SignalPocket/archive-module-3030/README.md

# ARCHIVE MODULE 3030 — production candidate

This version uses the tested dimensions and replaces the unreliable flex latch with a magnetic drawer detent.

> Private personal project. Please do not publish, share, fork, or redistribute the proposal text or artwork.

## Repository contents

- `print-files/` — six separate plate-ready 3MF jobs; start here for Bambu Studio.
- `models/` — editable OpenSCAD source, assembled reference 3MF, and individual printable STL parts.
- `docs/TRANSMISSION.txt` — final proposal transmission copy.
- `docs/assembly-diagram.html` — interactive exploded, closed, and open assembly sketches.
- `docs/lego-style-assembly-guide.svg` — numbered four-step hardware and layer assembly guide.
- `renders/final-assembly-diagram.png` — accurate closed/reveal comparison rendered directly from the approved SCAD geometry.
- `renders/assembly_preview.png` — assembled color preview.
- `history/` — the complete sequence of calibration parts, prototypes, discarded mechanisms, early models, build scripts, renders, and original ZIP packages.
- [`EVOLUTION.md`](EVOLUTION.md) — what changed at each stage and what the physical tests taught us.

## Visual construction

- Black PLA chassis and top lid.
- Iron-gray PLA drawer and armor plate.
- Yellow PETG timeline overlay, secured by four exposed M2 × 8 mm event screws.
- Two hidden black retaining clips capture the rear edge of the lid and armor.
- Parameterized black PLA lettering printed directly into/on the iron-gray armor as an AMS multicolor part.
- Each screw marks a completed archival event: 05.14.2023, 05.28.2023, 10.12.2023, and 08.29.2026.
- The open yellow ring nearest the drawer represents 09.26.2026: a record awaiting its response.
- Red PLA reveal plate inside the drawer.

## Calibrated dimensions

- Drawer clearance: 0.15 mm per side, derived from the successful 0.10 mm short-rail test with 0.05 mm full-length allowance.
- Magnet pockets: 6.10 × 3.20 mm.
- M2 clearance holes: 2.30 mm.
- M2 pilot holes: 1.70 mm.

## Print order

Do not begin with the large chassis.

Use the numbered jobs in `print-files/`. The combined 3MF under `models/` is an assembled reference and is not intended to be sliced as one plate.

1. Print `models/drawer_gray.stl` and verify that the magnet seats in its pocket without force.
2. Print `models/chassis_black.stl`. Before adding adhesive, slide the empty drawer through its full travel.
3. Install the two magnets only after checking their attraction direction. Use a tiny amount of thick CA or two-part epoxy.
4. Print `models/lid_black.stl`, `models/armor_gray.stl`, and `models/timeline_yellow.stl`.
5. For the armor, import `models/armor_gray.stl` and `models/top_text_black.stl` together as one object with multiple parts. Assign iron-gray PLA to the armor and black PLA to the text. The meshes are already aligned; do not auto-arrange them separately.
6. Stack lid → armor → yellow timeline. Angle the stack slightly, tuck its rear edge beneath both black retaining clips, then lower the front edge. Install four M2 × 8 mm screws through the completed-event nodes. Tighten only until seated; PETG can deform if overtightened.
7. Print `models/reveal_red.stl`, check its reading orientation, and install it in the drawer.
8. Add the folded transmission last.

## Editing the top wording

Open `models/archive_module_3030_final.scad` and change `TITLE_TEXT` or `STATUS_TEXT` near the top. Export both `armor` and `top_text` after changing the wording so their registration surfaces continue to match. The circular date dials are controlled by `EVENT_YEARS`, `EVENT_DAYS`, `OPEN_EVENT_YEAR`, and `OPEN_EVENT_DAY`.

## Opening grip

The drawer is opened through the widened concealed window on the underside. Five shallow grooves in the drawer floor provide traction while pulling directly against the magnet pair.

## Suggested settings

- Chassis: Black PLA, flat bottom on the build plate with the open tray facing upward; 0.20 mm, 4 walls, 20% gyroid, no supports expected.
- Drawer: Iron Gray PLA, flat bottom on the plate, 0.20 mm, 4 walls, 20% gyroid, no supports.
- Lid and armor: flat, 0.16–0.20 mm, 4 walls.
- Yellow timeline: Yellow PETG HF, flat, 0.16 mm, 5 walls, 100% infill, no supports.
- Red reveal: Red PLA, flat, 0.16 mm; ironing optional.

## Important

This is the first full-size production candidate. Test the empty drawer before installing magnets, the red reveal, or the transmission. Keep the four top screws snug rather than tight.
