SignalPocket/archive-module-3030/extras/keychain/renders/john_3030_keychain_preview.png

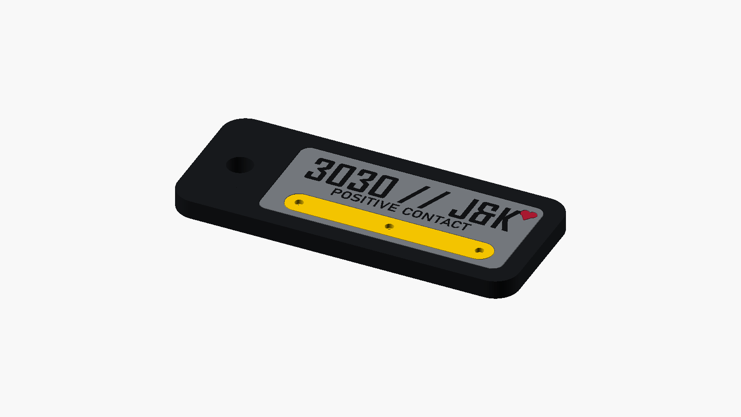
extras/keychain/renders/john_3030_keychain_preview.png
