SignalPocket/archive-module-3030/renders/final_closed.png

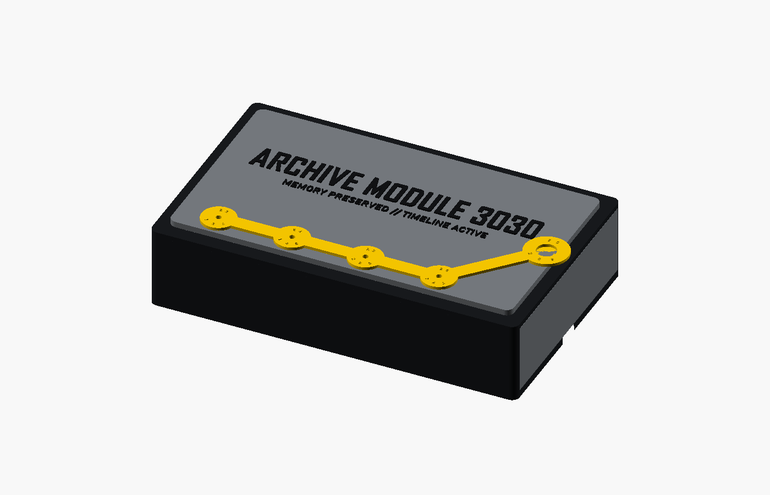
renders/final_closed.png
