SignalPocket/archive-module-3030/renders/final_open.png

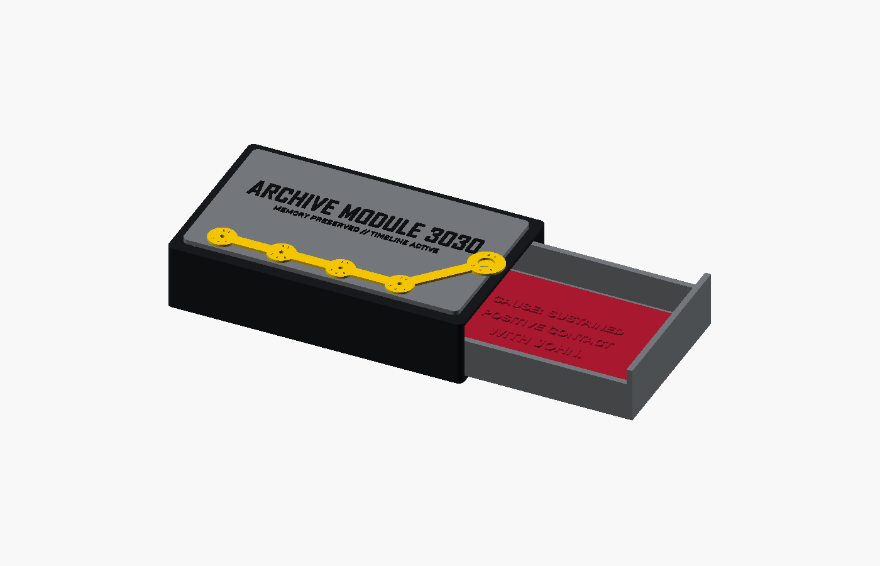
renders/final_open.png
