SignalPocket/archive-module-3030/extras/keychain/models/face_gray.stl

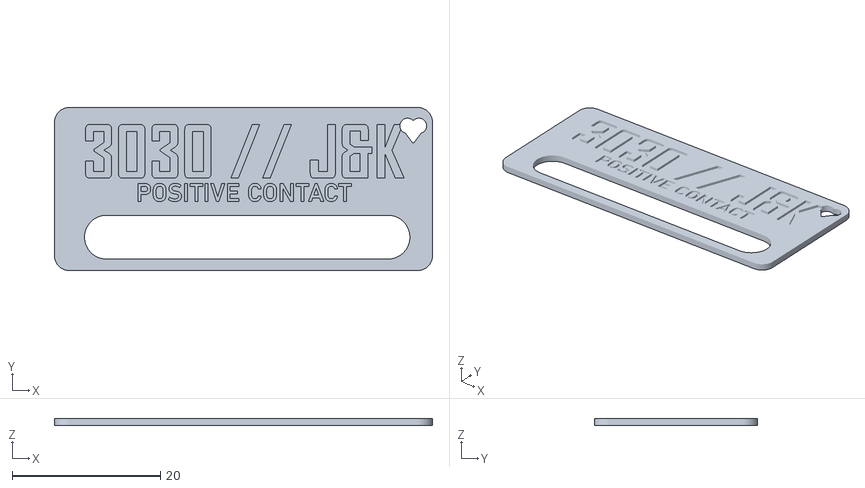
[picture p4: CAD file, 2026-09-24]
extras/keychain/models/face_gray.stl
51.0 x 22.0 x 1.00
