SignalPocket/archive-module-3030/extras/keychain/print-files/01_keychain_black_gray_red_ams.3mf

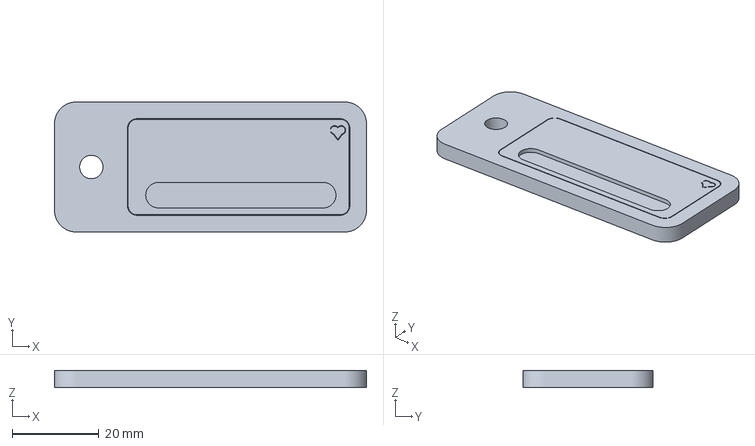
[picture p5: CAD file, 2026-10-22]
extras/keychain/print-files/01_keychain_black_gray_red_ams.3mf
72.0 x 30.0 x 4.00 mm
