SignalPocket/archive-module-3030/history/01-printer-calibration/storage_case_slider.stl

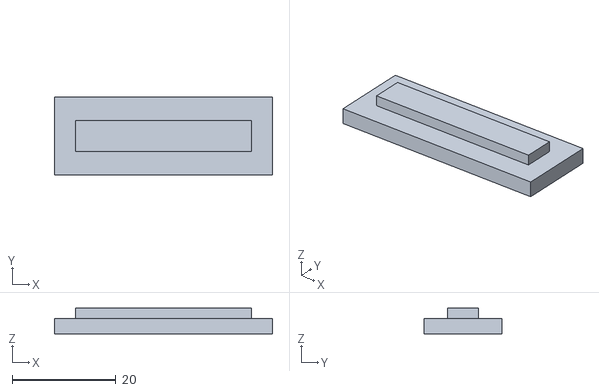
[picture p6: CAD file, 2026-09-23]
history/01-printer-calibration/storage_case_slider.stl
42.0 x 15.0 x 5.00
