SignalPocket/archive-module-3030/history/02-printer-calibration-v2/magnet_sleeve_610.stl

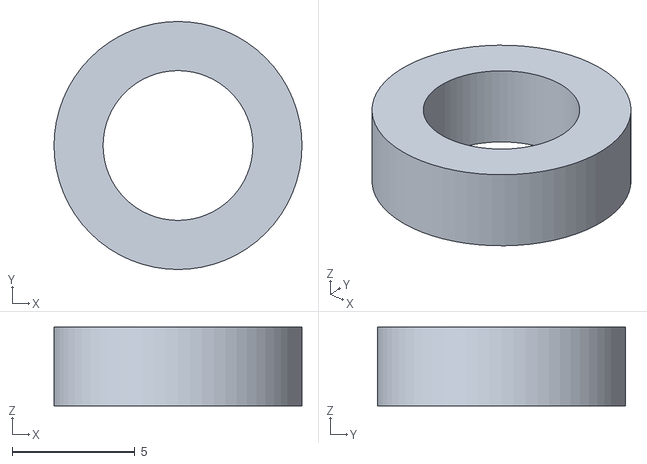
[picture p7: CAD file, 2026-09-23]
history/02-printer-calibration-v2/magnet_sleeve_610.stl
10.1 x 10.1 x 3.20
