SignalPocket/archive-module-3030/history/03-printer-calibration-v3/rail_clearance_020.stl

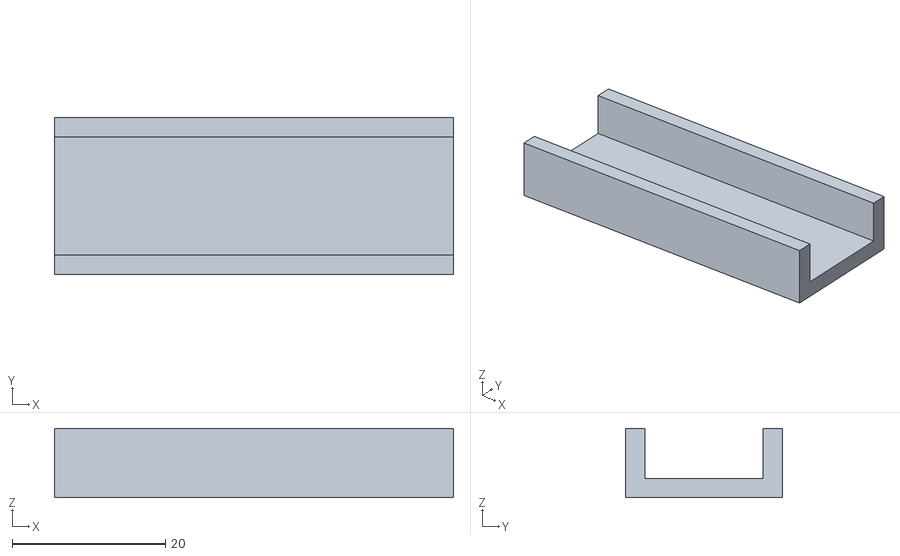
[picture p8: CAD file, 2026-09-23]
history/03-printer-calibration-v3/rail_clearance_020.stl
52.0 x 20.4 x 9.00
