SignalPocket/archive-module-3030/history/04-petg-flexure/flexure_180.stl

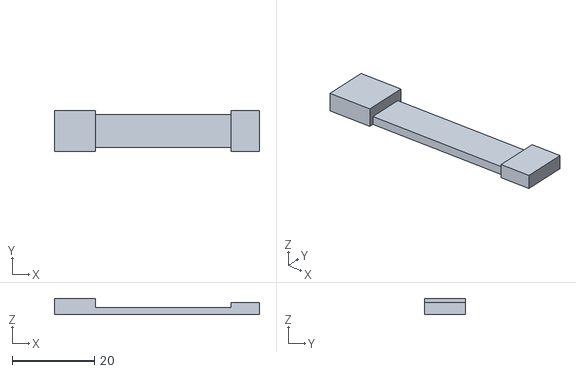
[picture p9: CAD file, 2026-09-23]
history/04-petg-flexure/flexure_180.stl
50.0 x 10.0 x 4.00
