SignalPocket/archive-module-3030/history/05-latch-catch-test/catch_slider_gray.stl

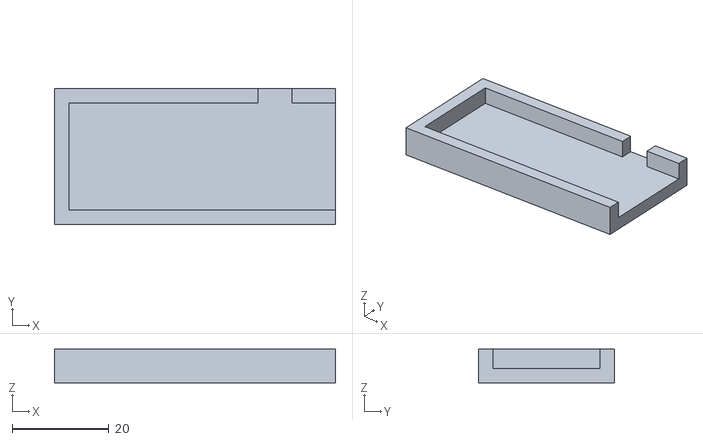
[picture p10: CAD file, 2026-09-23]
history/05-latch-catch-test/catch_slider_gray.stl
58.0 x 28.0 x 7.00
