SignalPocket/archive-module-3030/history/06-first-full-concept/reveal_plate_red.stl

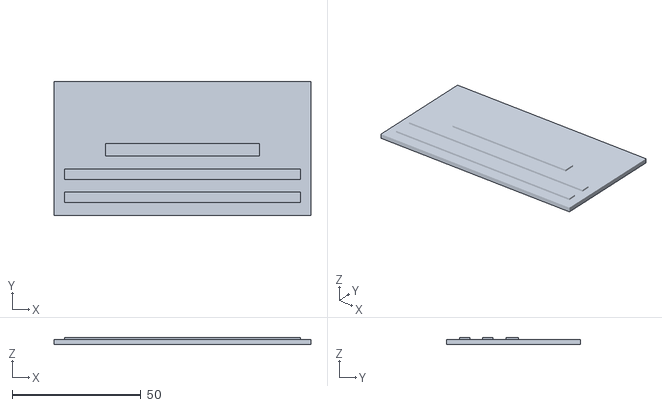
[picture p11: CAD file, 2026-09-23]
history/06-first-full-concept/reveal_plate_red.stl
100.0 x 52.0 x 2.80
