SignalPocket/archive-module-3030/history/08-approved-model-v2/models/reveal_red.stl

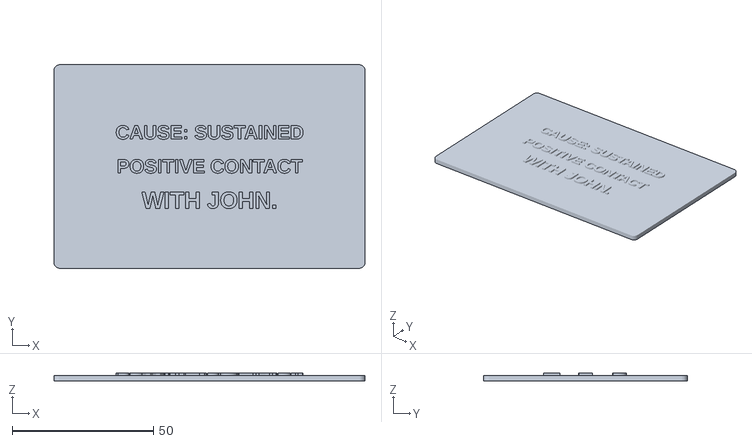
[picture p12: CAD file, 2026-09-23]
history/08-approved-model-v2/models/reveal_red.stl
110.0 x 72.0 x 2.80
