SignalPocket/archive-module-3030/models/drawer_gray.3mf

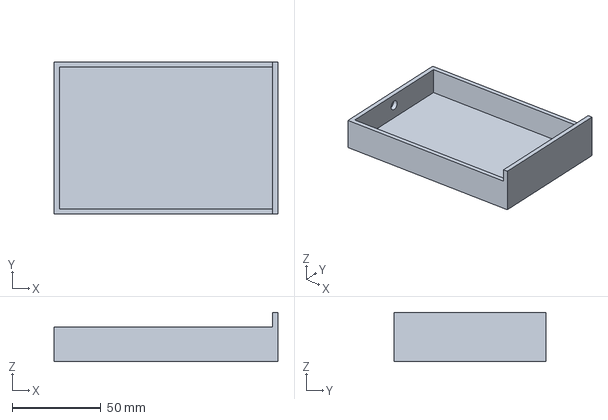
[picture p13: CAD file, 2026-10-22]
models/drawer_gray.3mf
126.0 x 85.7 x 27.7 mm
