SignalPocket/archive-module-3030/print-files/04_armor_gray_black_ams.3mf

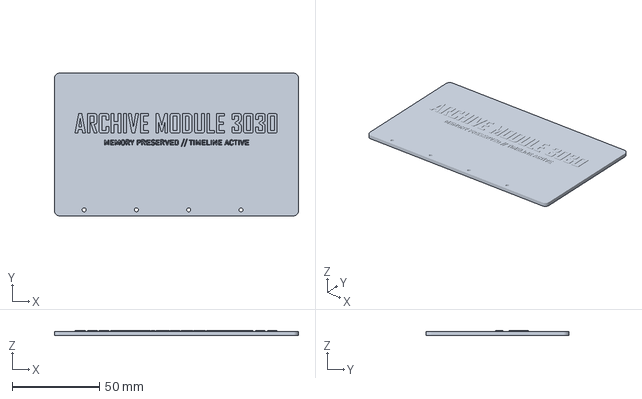
[picture p14: CAD file, 2026-10-22]
print-files/04_armor_gray_black_ams.3mf
140.0 x 82.0 x 3.00 mm
