SignalPocket/archive-module-3030/extras/keychain/models/text_black.stl

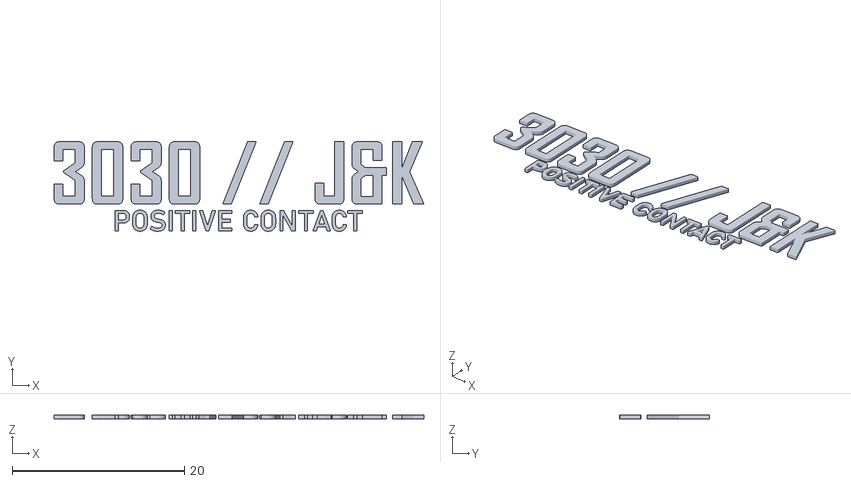
[picture p15: CAD file, 2026-09-24]
extras/keychain/models/text_black.stl
43.0 x 10.4 x 0.42
