SignalPocket/archive-module-3030/extras/keychain/print-files/02_signal_yellow_petg.3mf

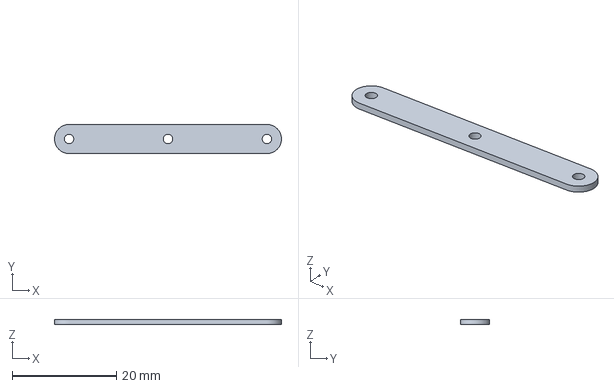
[picture p16: CAD file, 2026-10-22]
extras/keychain/print-files/02_signal_yellow_petg.3mf
43.6 x 5.60 x 1.00 mm
