SignalPocket/archive-module-3030/history/01-printer-calibration/storage_case_rail.3mf

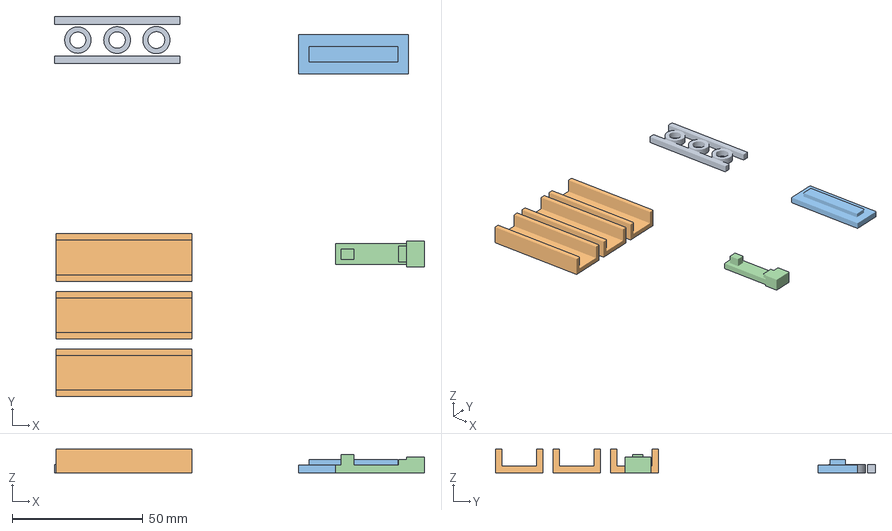
[picture p17: CAD file, 2026-09-23]
history/01-printer-calibration/storage_case_rail.3mf
141.5 x 145.2 x 9.00 mm
magnet_fit_coupon.stl
storage_case_rail.stl
storage_case_slider.stl
cable_clip_flex_test.stl
