SignalPocket/archive-module-3030/history/02-printer-calibration-v2/m2_clearance_230.stl

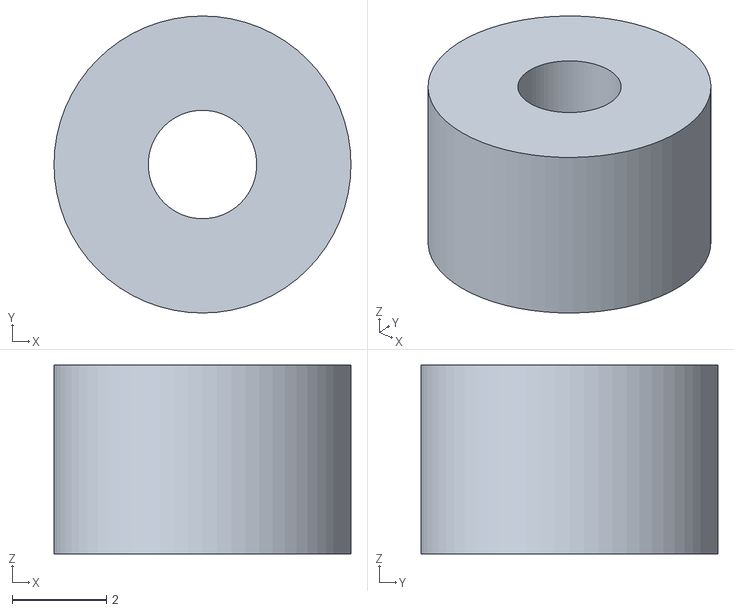
[picture p18: CAD file, 2026-09-23]
history/02-printer-calibration-v2/m2_clearance_230.stl
6.30 x 6.30 x 4.00
