SignalPocket/archive-module-3030/history/04-petg-flexure/flexure_120.stl

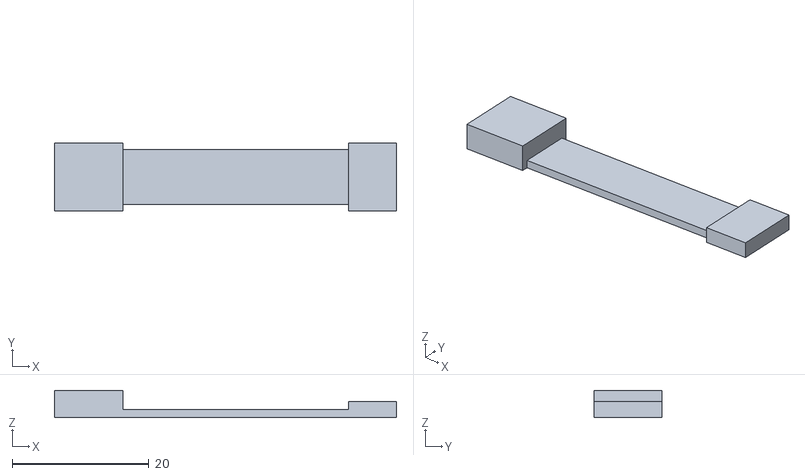
[picture p19: CAD file, 2026-09-23]
history/04-petg-flexure/flexure_120.stl
50.0 x 10.0 x 4.00
