SignalPocket/archive-module-3030/history/05-latch-catch-test/latch_test_jig_black.stl

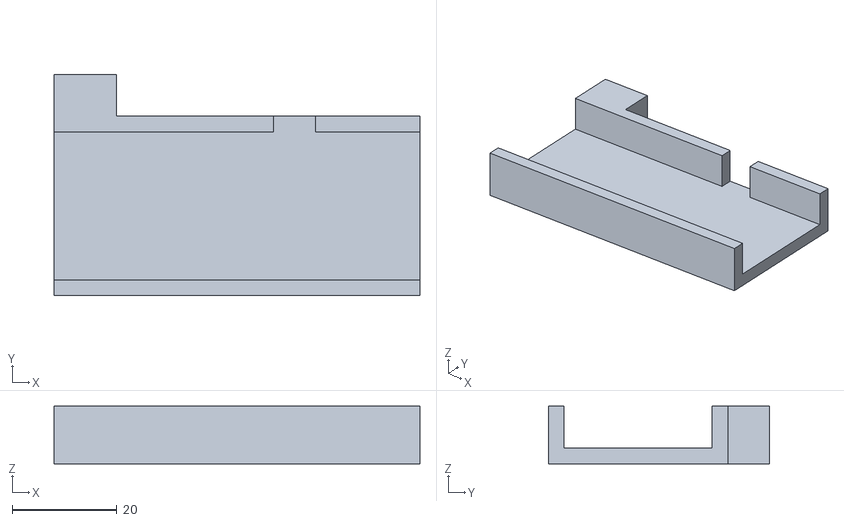
[picture p20: CAD file, 2026-09-23]
history/05-latch-catch-test/latch_test_jig_black.stl
70.0 x 42.3 x 11.0
