SignalPocket/archive-module-3030/history/06-first-full-concept/security_bar_yellow.stl

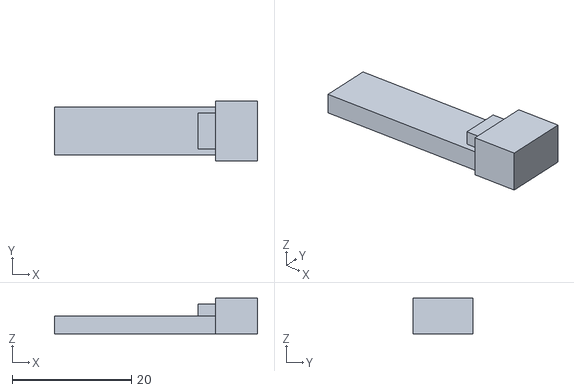
[picture p21: CAD file, 2026-09-23]
history/06-first-full-concept/security_bar_yellow.stl
34.0 x 10.0 x 6.00
