SignalPocket/archive-module-3030/history/08-approved-model-v2/models/armor_gray.stl

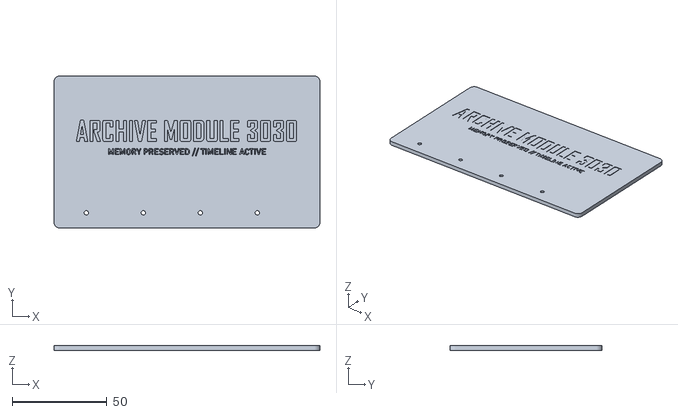
[picture p22: CAD file, 2026-09-23]
history/08-approved-model-v2/models/armor_gray.stl
140.0 x 80.0 x 2.40
