SignalPocket/archive-module-3030/models/d.3mf

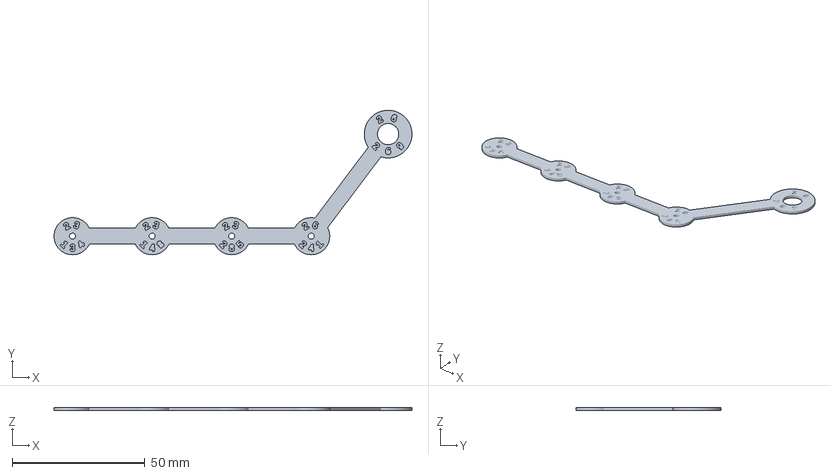
[picture p23: CAD file, 2026-10-22]
models/d.3mf
135.0 x 54.5 x 1.20 mm
