SignalPocket/archive-module-3030/print-files/01_chassis_black.3mf

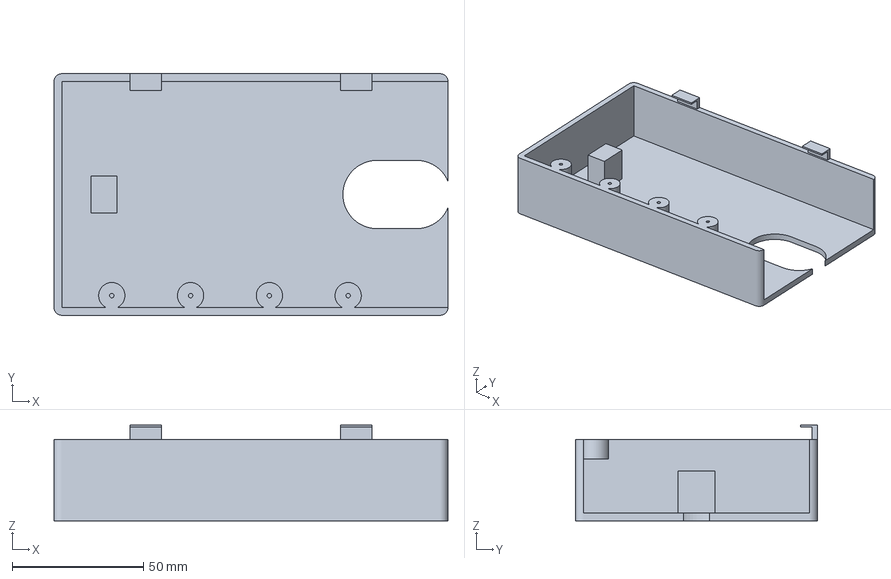
[picture p24: CAD file, 2026-10-22]
print-files/01_chassis_black.3mf
150.0 x 92.0 x 36.5 mm
