SignalPocket/archive-module-3030/extras/keychain/models/indicator_red.stl

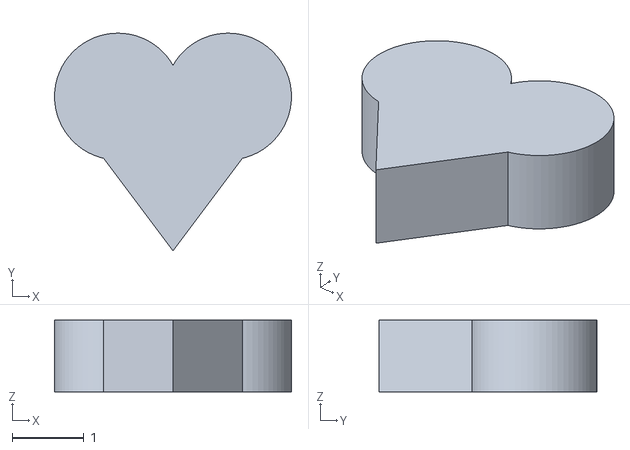
[picture p25: CAD file, 2026-09-24]
extras/keychain/models/indicator_red.stl
3.30 x 3.03 x 1.00
