SignalPocket/archive-module-3030/history/01-printer-calibration/storage_case_rail_corrected.stl

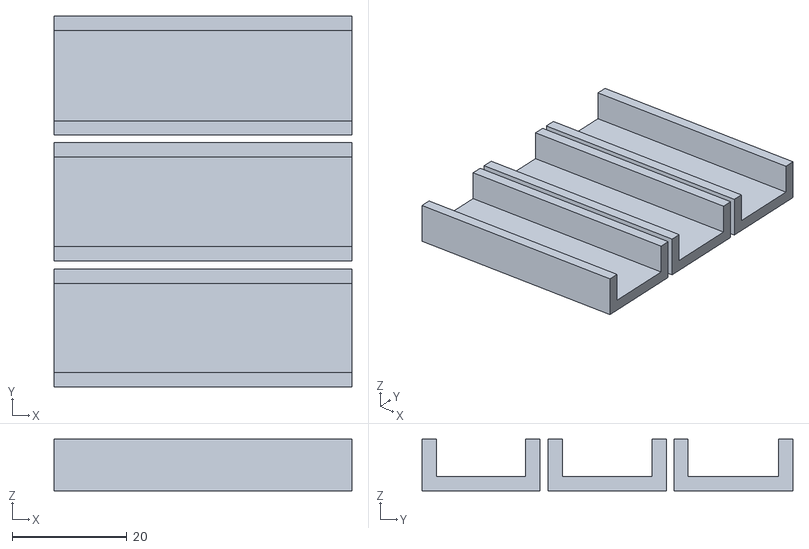
[picture p26: CAD file, 2026-09-23]
history/01-printer-calibration/storage_case_rail_corrected.stl
52.0 x 64.8 x 9.00
