SignalPocket/archive-module-3030/history/05-latch-catch-test/security_flexure_180_yellow.stl

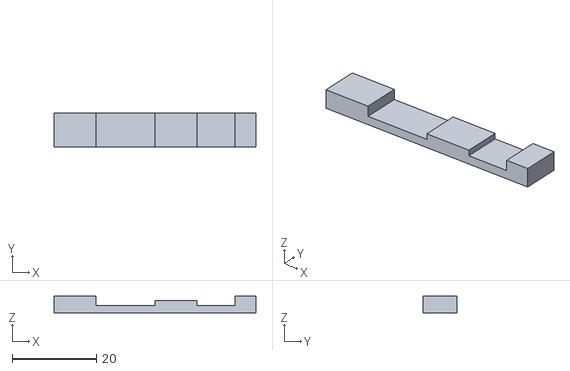
[picture p28: CAD file, 2026-09-23]
history/05-latch-catch-test/security_flexure_180_yellow.stl
48.0 x 8.00 x 4.00
