SignalPocket/archive-module-3030/history/06-first-full-concept/tolerance_test.stl

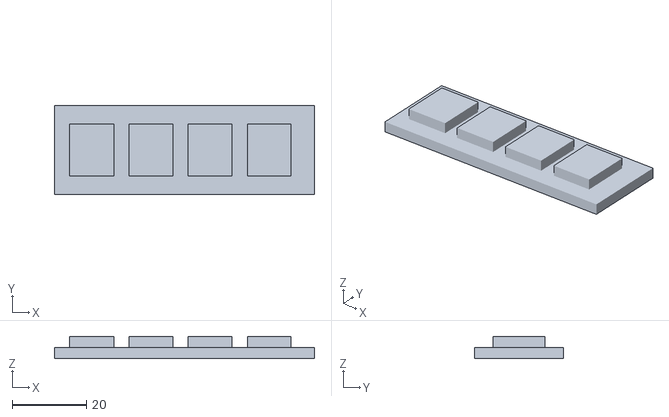
[picture p29: CAD file, 2026-09-23]
history/06-first-full-concept/tolerance_test.stl
70.0 x 24.0 x 6.00
