SignalPocket/archive-module-3030/models/timeline_yellow.stl

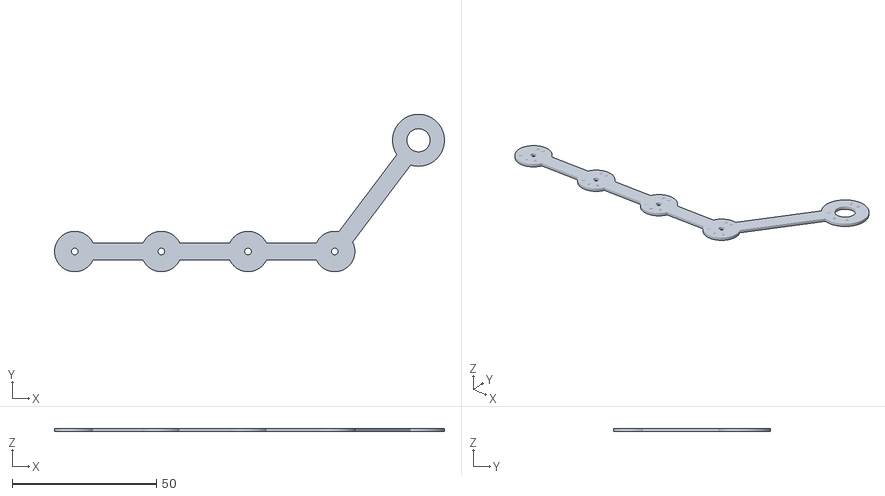
[picture p30: CAD file, 2026-09-23]
models/timeline_yellow.stl
135.0 x 54.5 x 1.20
