SignalPocket/archive-module-3030/extras/keychain/models/base_black.stl

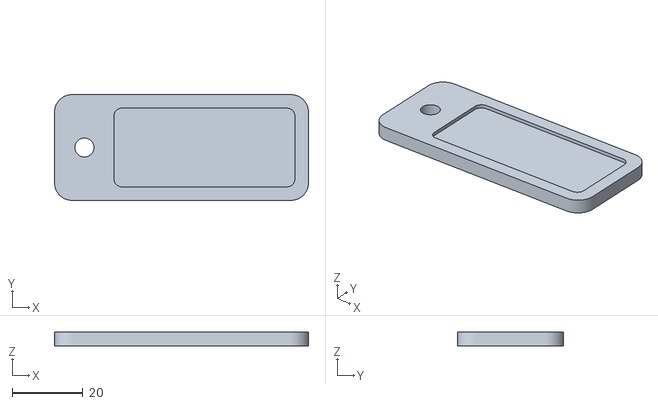
[picture p31: CAD file, 2026-09-24]
extras/keychain/models/base_black.stl
72.0 x 30.0 x 4.00
