SignalPocket/archive-module-3030/history/01-printer-calibration/magnet_fit_coupon.stl

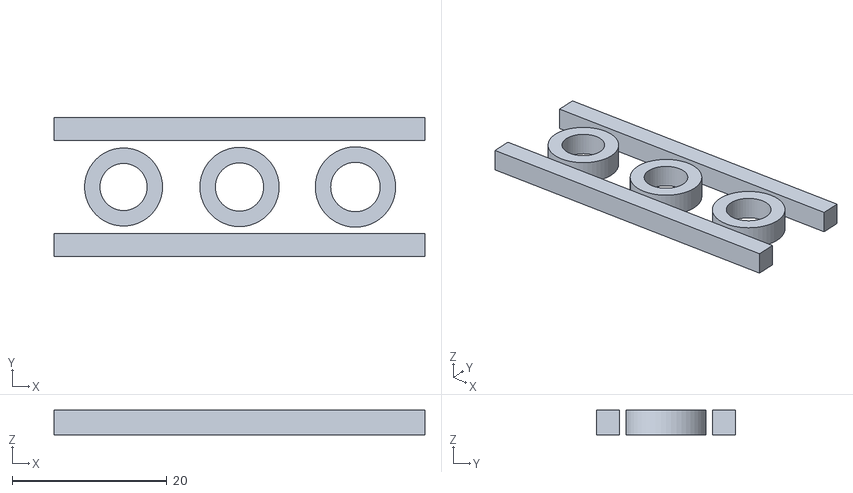
[picture p32: CAD file, 2026-09-23]
history/01-printer-calibration/magnet_fit_coupon.stl
48.0 x 18.0 x 3.20
