SignalPocket/archive-module-3030/history/02-printer-calibration-v2/rail_clearance_040.stl

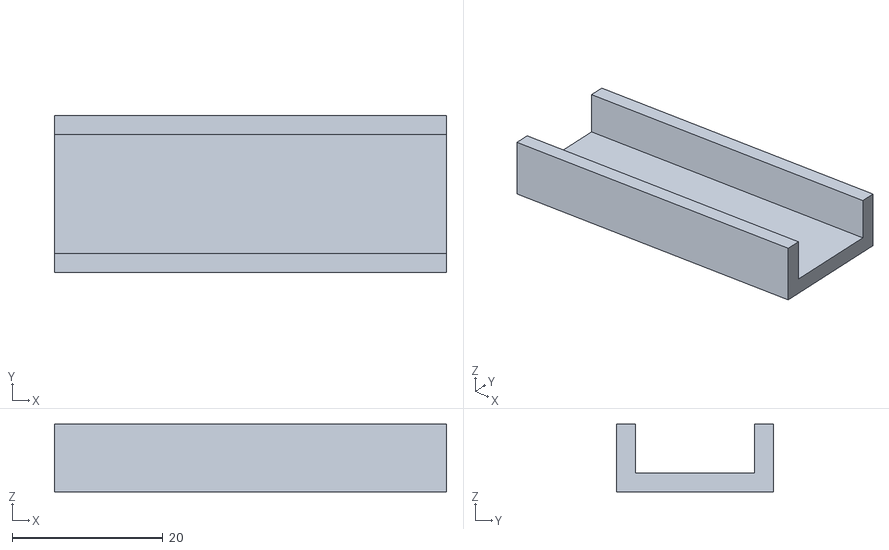
[picture p33: CAD file, 2026-09-23]
history/02-printer-calibration-v2/rail_clearance_040.stl
52.0 x 20.8 x 9.00
