SignalPocket/archive-module-3030/history/06-first-full-concept/drawer_iron_gray.stl

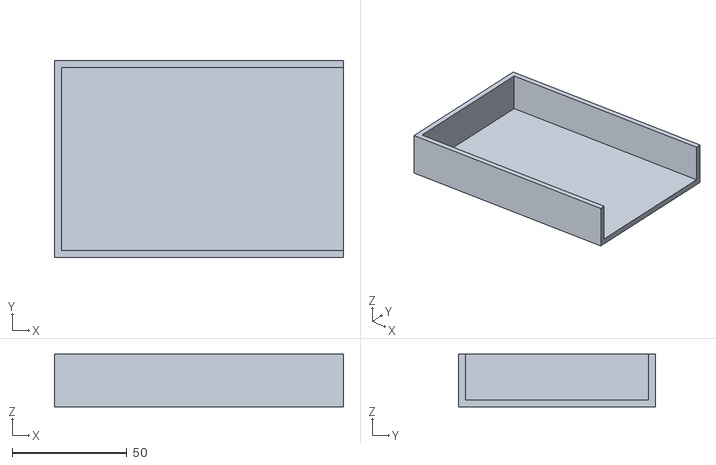
[picture p34: CAD file, 2026-09-23]
history/06-first-full-concept/drawer_iron_gray.stl
126.0 x 85.7 x 23.0
