SignalPocket/archive-module-3030/history/08-approved-model-v2/models/top_text_black.stl

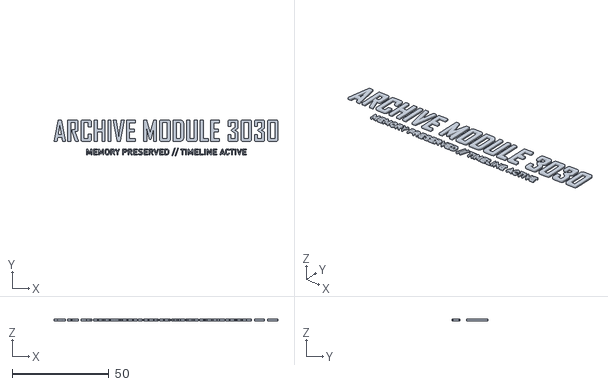
[picture p35: CAD file, 2026-09-23]
history/08-approved-model-v2/models/top_text_black.stl
116.0 x 18.7 x 0.85
