SignalPocket/archive-module-3030/history/01-printer-calibration/cable_clip_flex_test.stl

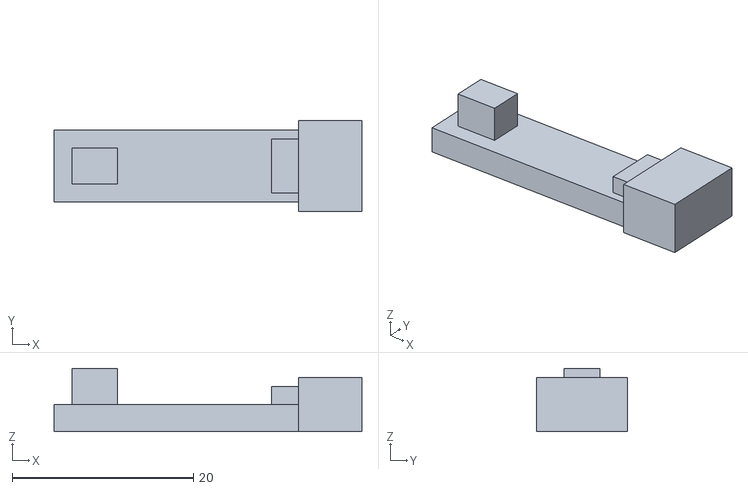
[picture p36: CAD file, 2026-09-23]
history/01-printer-calibration/cable_clip_flex_test.stl
34.0 x 10.0 x 7.00
