SignalPocket/archive-module-3030/history/08-approved-model-v2/models/chassis_black.stl

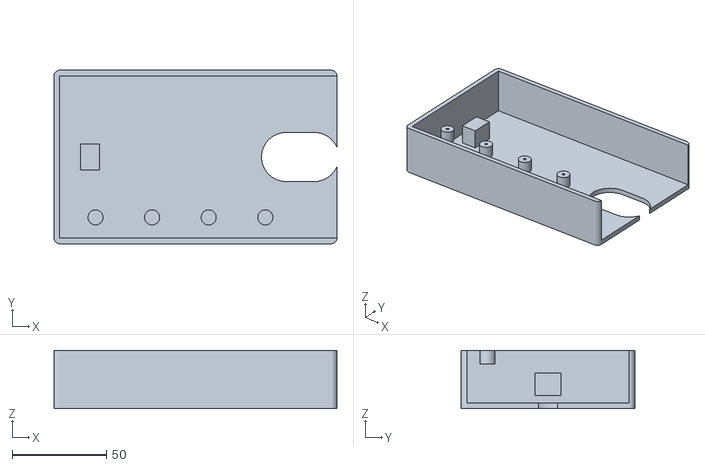
[picture p37: CAD file, 2026-09-23]
history/08-approved-model-v2/models/chassis_black.stl
150.0 x 92.0 x 31.0
