SignalPocket/archive-module-3030/models/armor_gray.stl

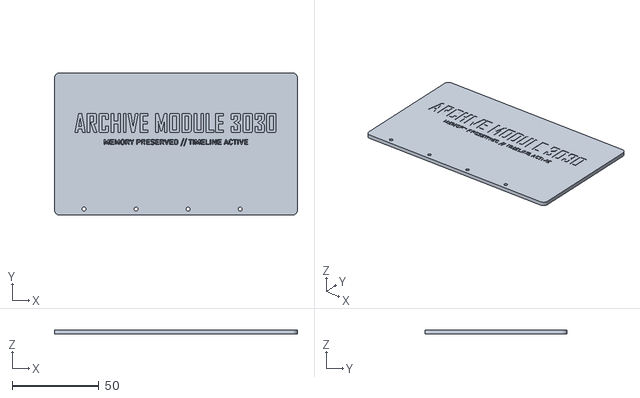
[picture p38: CAD file, 2026-09-23]
models/armor_gray.stl
140.0 x 82.0 x 2.40
