SignalPocket/archive-module-3030/print-files/03_lid_black.3mf

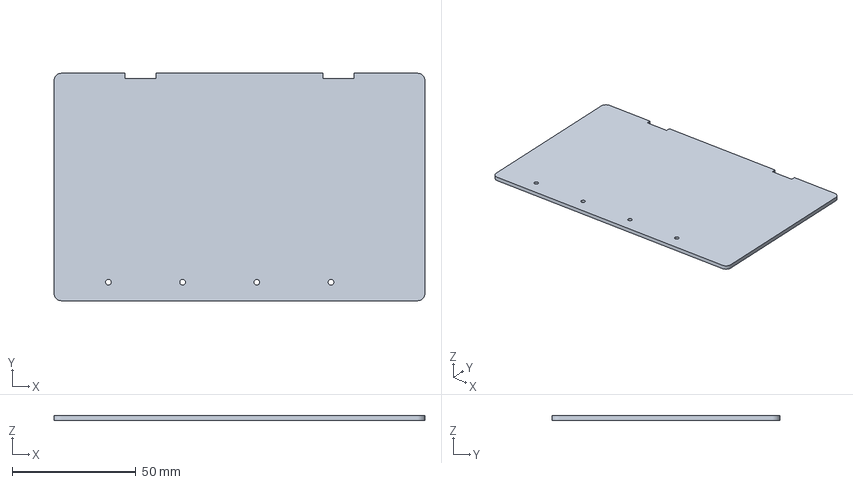
[picture p39: CAD file, 2026-10-22]
print-files/03_lid_black.3mf
150.0 x 92.0 x 2.00 mm
