SignalPocket/archive-module-3030/history/02-printer-calibration-v2/m2_pilot_170.stl

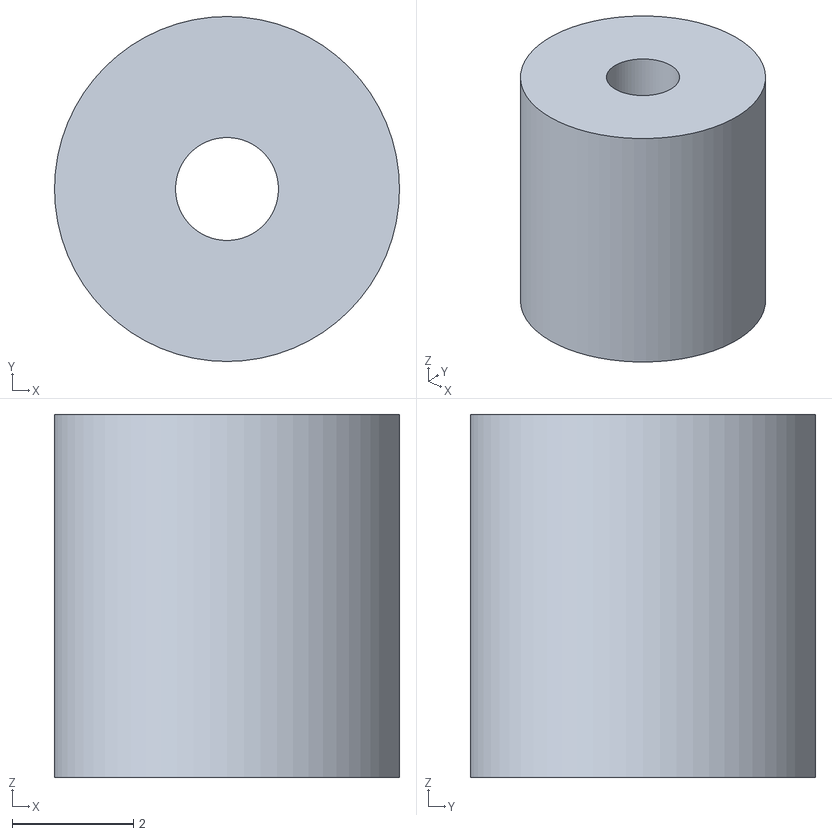
[picture p40: CAD file, 2026-09-23]
history/02-printer-calibration-v2/m2_pilot_170.stl
5.70 x 5.70 x 6.00
