SignalPocket/archive-module-3030/history/06-first-full-concept/armor_iron_gray.stl

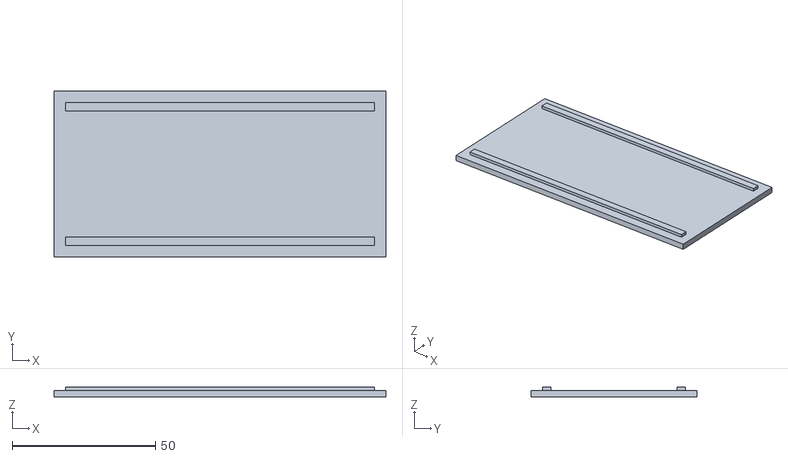
[picture p41: CAD file, 2026-09-23]
history/06-first-full-concept/armor_iron_gray.stl
116.0 x 58.0 x 3.60
