SignalPocket/archive-module-3030/history/08-approved-model-v2/models/timeline_yellow.stl

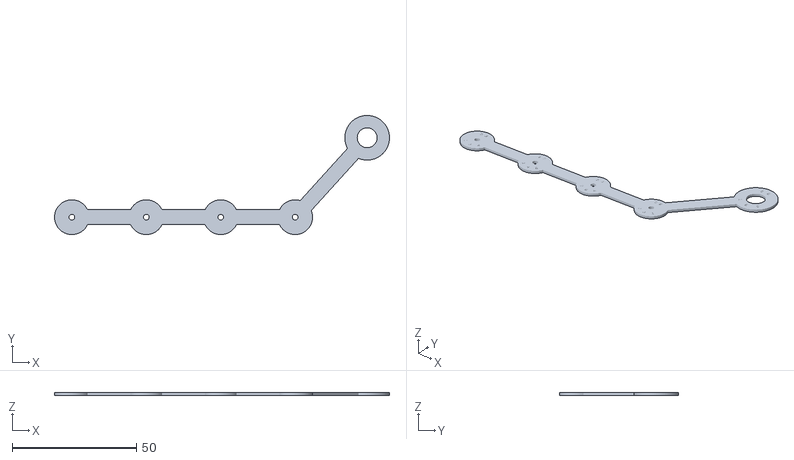
[picture p42: CAD file, 2026-09-23]
history/08-approved-model-v2/models/timeline_yellow.stl
135.0 x 48.0 x 1.20
