SignalPocket/archive-module-3030/history/06-first-full-concept/shell_black.stl

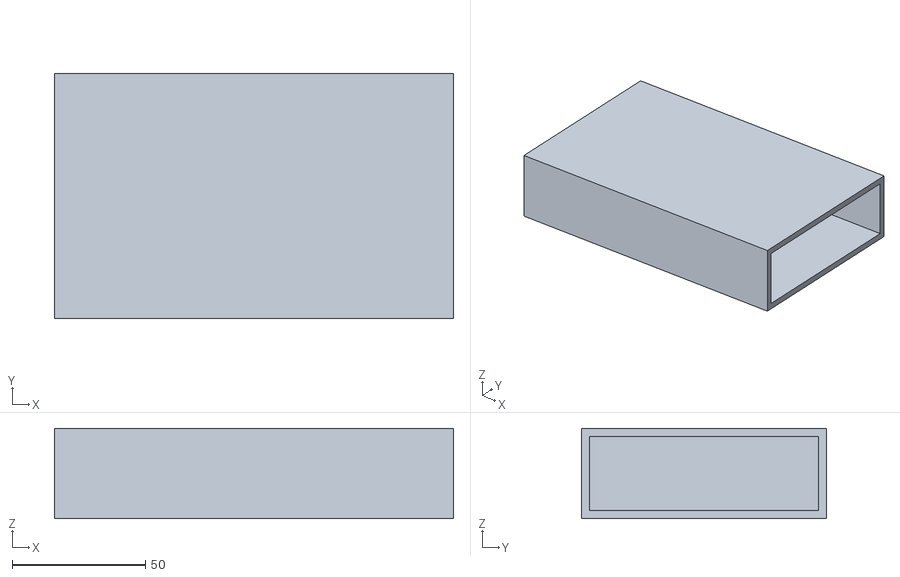
[picture p43: CAD file, 2026-09-23]
history/06-first-full-concept/shell_black.stl
150.0 x 92.0 x 34.0
