SignalPocket/archive-module-3030/history/08-approved-model-v2/models/lid_black.stl

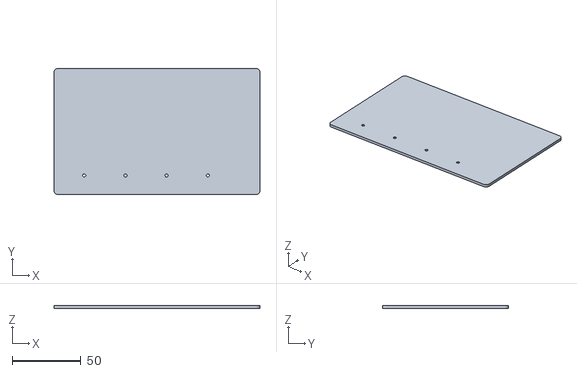
[picture p44: CAD file, 2026-09-23]
history/08-approved-model-v2/models/lid_black.stl
150.0 x 92.0 x 2.00
