SignalPocket/archive-module-3030/(list of files, cad)

Other CAD files:
history/03-printer-calibration-v3/rail_clearance_025.stl
history/03-printer-calibration-v3/rail_clearance_010.stl
history/04-petg-flexure/flexure_150.stl
history/08-approved-model-v2/models/drawer_gray.stl
print-files/06_reveal_red.3mf
history/03-printer-calibration-v3/rail_clearance_015.stl
print-files/02_drawer_gray.3mf
extras/keychain/models/signal_yellow_petg.stl
history/02-printer-calibration-v2/slider_reference.stl
models/chassis_black.stl
print-files/05_timeline_yellow_petg.3mf
history/02-printer-calibration-v2/rail_clearance_035.stl
models/lid_black.stl
models/archive_module_3030_final - Copy.scad
models/archive_module_3030_final.scad
history/01-printer-calibration/storage_case_rail.stl
history/06-first-full-concept/archive_module_3030.3mf
history/06-first-full-concept/archive_module_3030.scad
history/07-final-production-candidate/archive_module_3030_final.3mf
history/07-final-production-candidate/archive_module_3030_final.scad
history/07-final-production-candidate/armor_gray.stl
history/07-final-production-candidate/chassis_black.stl
history/07-final-production-candidate/drawer_gray.stl
history/07-final-production-candidate/lid_black.stl
history/07-final-production-candidate/reveal_red.stl
history/07-final-production-candidate/timeline_yellow.stl
history/08-approved-model-v2/models/archive_module_3030_final - Copy.scad
history/08-approved-model-v2/models/archive_module_3030_final.3mf
history/08-approved-model-v2/models/archive_module_3030_final.scad
models/archive_module_3030_final.3mf
models/d.stl
models/drawer_gray.stl
