SignalPocket/archive-module-3030/history/08-approved-model-v2/renders/final-assembled-sketch.png

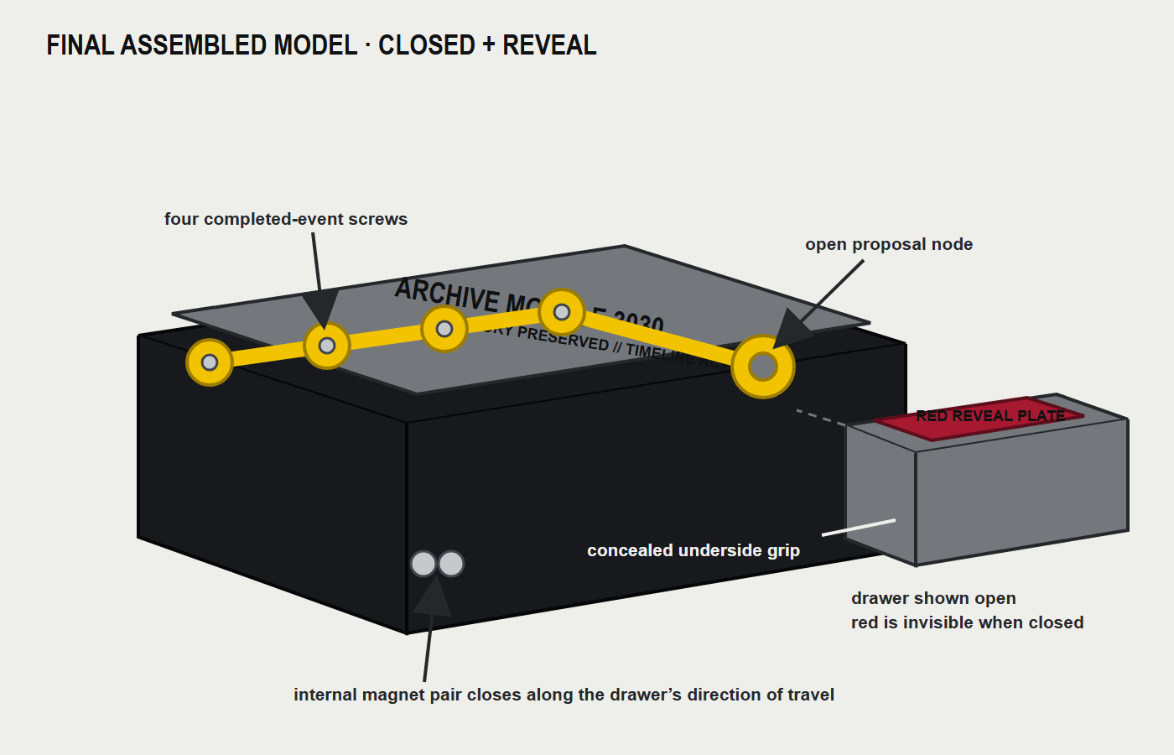
history/08-approved-model-v2/renders/final-assembled-sketch.png
