SignalPocket/archive-module-3030/history/08-approved-model-v2/renders/lego-style-assembly-guide.png

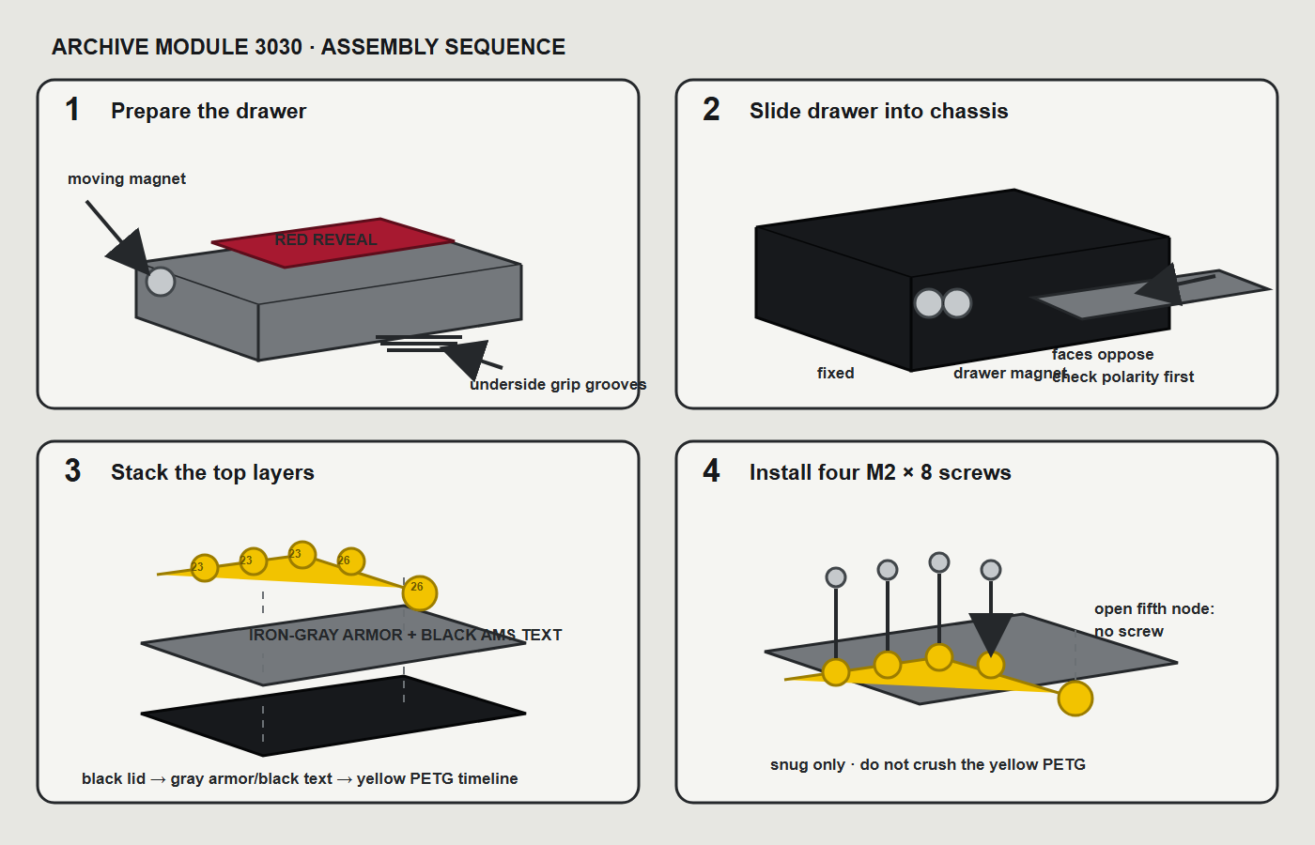
history/08-approved-model-v2/renders/lego-style-assembly-guide.png
