SignalPocket/archive-module-3030/renders/final-assembly-diagram.png

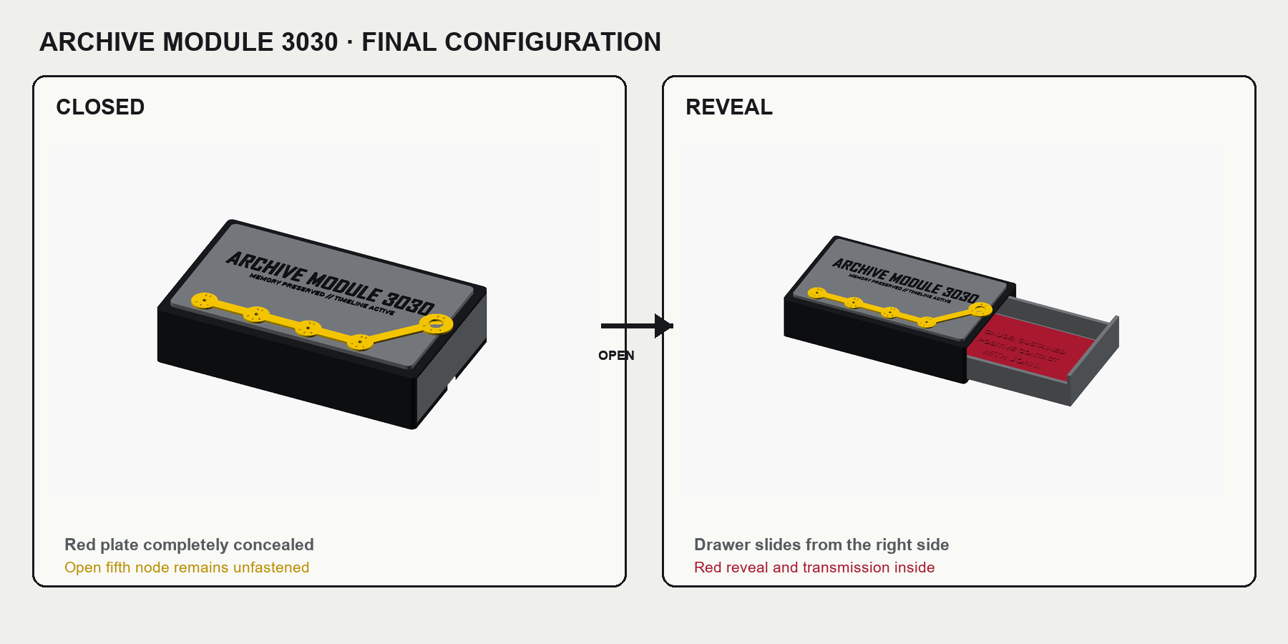
renders/final-assembly-diagram.png
