SignalPocket/archive-module-3030/(commit log)

2026-09-23 Initial private Archive Module 3030 project
    [archive_module_3030_final.3mf, archive_module_3030_final.scad, armor_gray.stl, chassis_black.stl, drawer_gray.stl, lid_black.stl, reveal_red.stl, timeline_yellow.stl]
2026-09-23 Archive complete design evolution and prototypes
    [archive_module_3030.3mf, archive_module_3030.scad, archive_module_3030_final.3mf, archive_module_3030_final.scad, armor_gray.stl, armor_iron_gray.stl, cable_clip_flex_test.stl, catch_slider_gray.stl]
2026-09-23 Approve model v2 with archival date dials and assembly guides
    [archive_module_3030_final - Copy.scad, archive_module_3030_final.3mf, archive_module_3030_final.scad, armor_gray.stl, chassis_black.stl, drawer_gray.stl, lid_black.stl, reveal_red.stl]
2026-09-23 Replace final sketch with accurate SCAD-rendered diagram
    [archive_module_3030_final.scad]
2026-09-23 Add plate-ready Bambu print jobs and hidden rear retainers
    [01_chassis_black.3mf, 02_drawer_gray.3mf, 03_lid_black.3mf, 04_armor_gray_black_ams.3mf, 05_timeline_yellow_petg.3mf, 06_reveal_red.3mf, archive_module_3030_final.3mf, archive_module_3030_final.scad]
2026-09-23 Connect chassis bosses and rebuild print jobs
    [01_chassis_black.3mf, 02_drawer_gray.3mf, 03_lid_black.3mf, 04_armor_gray_black_ams.3mf, 05_timeline_yellow_petg.3mf, 06_reveal_red.3mf, archive_module_3030_final.3mf, archive_module_3030_final.scad]
2026-09-24 Add JOHN 3030 modular keychain
    [01_base_black.3mf, 02_face_gray_black_red_ams.3mf, 03_signal_yellow_petg.3mf, base_black.stl, face_gray.stl, indicator_red.stl, john_3030_keychain.scad, signal_yellow_petg.stl]
2026-09-24 Customize keychain with J&K and red heart
    [01_base_black.3mf, 02_face_gray_black_red_ams.3mf, 03_signal_yellow_petg.3mf, face_gray.stl, indicator_red.stl, john_3030_keychain.scad, text_black.stl]
2026-09-24 Lower keychain subtitle for clearer spacing
    [02_face_gray_black_red_ams.3mf, face_gray.stl, john_3030_keychain.scad, text_black.stl]
2026-09-24 Combine keychain PLA parts into one fused AMS job
    [01_base_black.3mf, 01_keychain_black_gray_red_ams.3mf, 02_face_gray_black_red_ams.3mf, 02_signal_yellow_petg.3mf, 03_signal_yellow_petg.3mf, face_gray.stl]
2026-09-24 Fix Bambu keychain filament colors
    [01_keychain_black_gray_red_ams.3mf]
2026-10-22 Preserve local print projects and model variants
    [01_chassis_black.3mf, 01_keychain_black_gray_red_ams.3mf, 02_drawer_gray.3mf, 02_signal_yellow_petg.3mf, 03_lid_black.3mf, 04_armor_gray_black_ams.3mf, 06_reveal_red.3mf, d.3mf]
